TheKerry/RV_main_pcb_ESP32/Software/0x036 CAN CONF.png

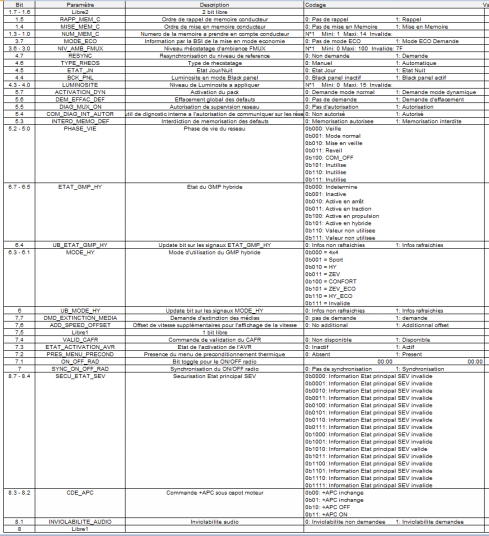
Software/0x036 CAN CONF.png
