TheKerry/RV_main_pcb_ESP32/Software/V1/readme.txt

CAN frames von Arduino auslesen und einzelne bits in Variablen speichern.
ESP fragt einfach nach 8 bits und bekommt diese zurück
