TheKerry/RV_main_pcb_ESP32/Software/0x1A CAN LS CAR.png

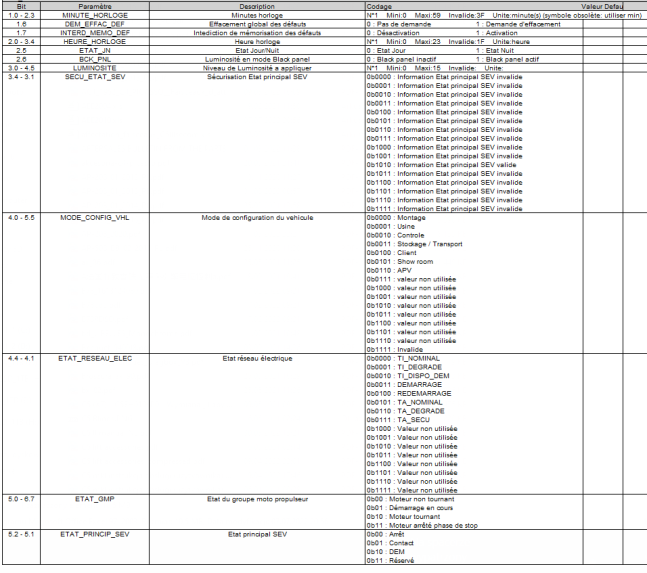
Software/0x1A CAN LS CAR.png
