TheKerry/RV_main_pcb_ESP32/RV_main_pcb_ESP32/RV_main_pcb_ESP32.kicad_pcb

## KiCad design RV_main_pcb_ESP32/RV_main_pcb_ESP32.kicad_pcb (2022-05-26)

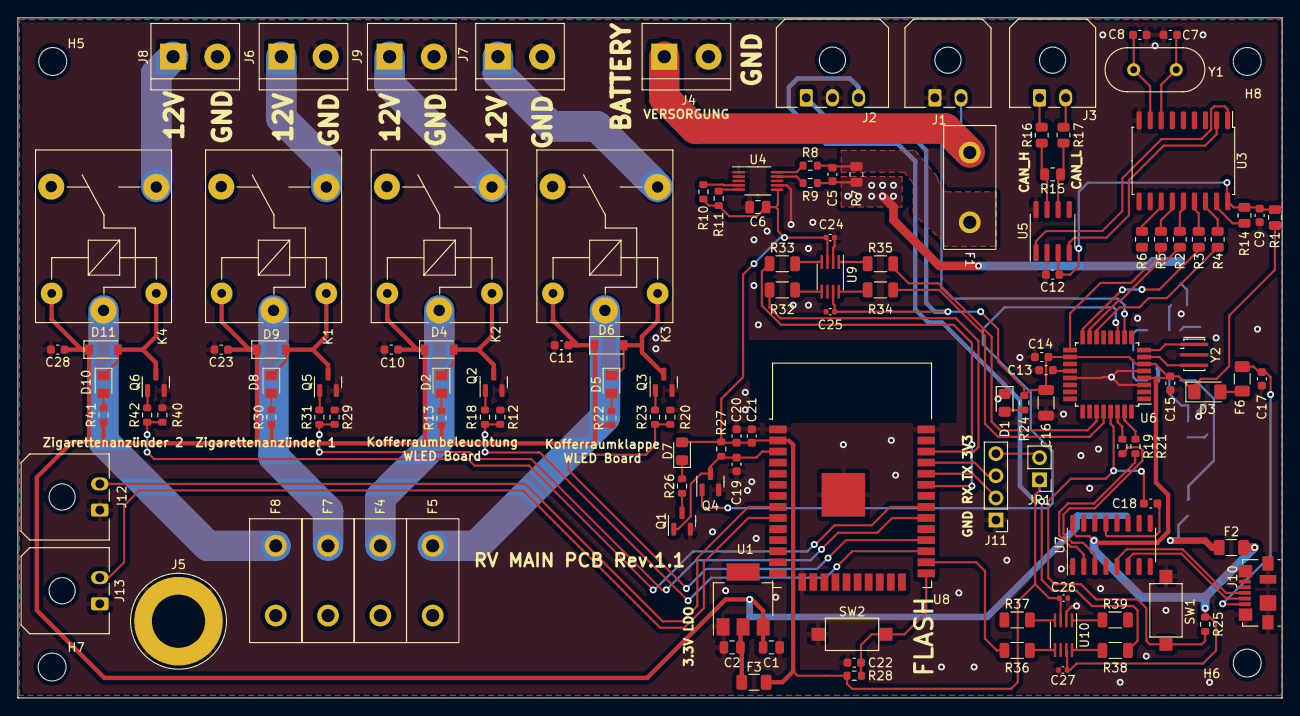
[picture p17: board RV_main_pcb_ESP32.kicad_pcb from above]

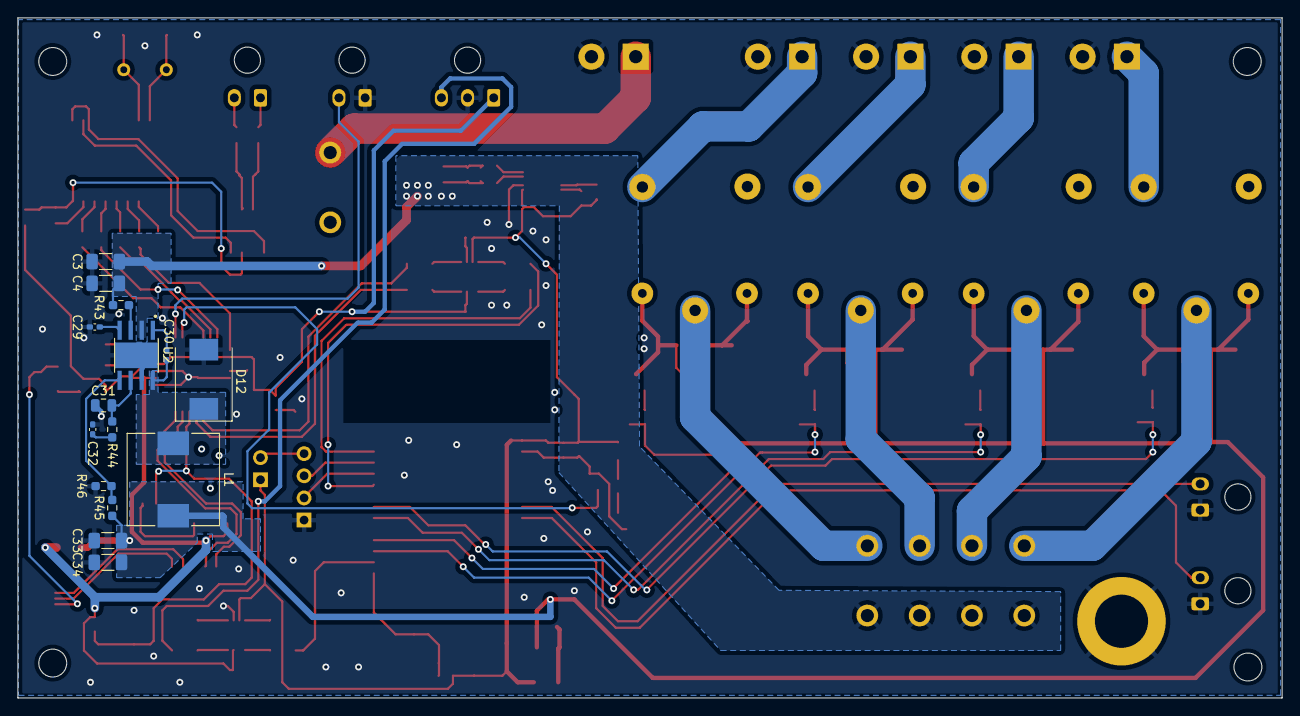
[picture p18: board RV_main_pcb_ESP32.kicad_pcb from below]

Board: 2 copper layers, 145.0 x 78.0 mm, 143 parts (15 on the bottom side), 101 nets.

Parts:
C1, C2, C6: 0.1uF; C_0805_2012Metric
C3, C4: 10uF; C_1206_3216Metric_Pad1.33x1.80mm_HandSolder
C5, C19, C22: 0.1uF; C_0603_1608Metric
C7, C8, C9, C12: C; C_0603_1608Metric
C10, C11, C23, C28: 10uF; C_0603_1608Metric
C13, C14, C15, C17, C18, C20: 100nF; C_0603_1608Metric
C16: 4,7uF 16V; C_1206_3216Metric
C21: 22uF; C_0603_1608Metric
C24, C25, C26, C27: 100nF; C_0402_1005Metric
C29: 22uF; C_0402_1005Metric_Pad0.74x0.62mm_HandSolder
C30, C32: 100nF; C_0402_1005Metric_Pad0.74x0.62mm_HandSolder
C31: 10pF; C_0805_2012Metric
C33, C34: 47uF; C_1206_3216Metric_Pad1.33x1.80mm_HandSolder
D1, D7: GREEN; LED_0805_2012Metric_Pad1.15x1.40mm_HandSolder
D2, D5, D8, D10: LED; LED_0805_2012Metric_Pad1.15x1.40mm_HandSolder
D3: D_Filled; D_1206_3216Metric_Pad1.42x1.75mm_HandSolder
D4, D6, D9, D11: 1N4148W; D_SOD-123
D12: B340; D_SMC
F1, F4, F5, F7, F8: 10A; Flachsicherung
F2, F6: 0.5A; Fuse_1206_3216Metric
F3: 1A; Fuse_1206_3216Metric
H5, H6, H7, H8: MountingHole; MountingHole_3.2mm_M3
J1, J3, J12, J13: Conn_01x02_Male; Molex_Micro-Fit_3.0_43650-0200_1x02_P3.00mm_Horizontal
J2: Molex Micro-fit 3x1; Molex_Micro-Fit_3.0_43650-0300_1x03_P3.00mm_Horizontal
J4, J6, J7, J8, J9: Conn_01x02_Male; TerminalBlock_bornier-2_P5.08mm
J5: Conn_01x01_Female; Banana_Jack_1Pin
J10: USB_B_Micro; USB_Micro-B_Molex_47346-0001
J11: Conn_01x04_Male; PinHeader_1x04_P2.54mm_Vertical
JP1: Jumper_2_Open; PinHeader_1x02_P2.54mm_Vertical
K1, K2, K3, K4: SANYOU_SRD_Form_C; Relay_SPDT_SANYOU_SRD_Series_Form_C
L1: 6.8uH; L_10.4x10.4_H4.8
Q1, Q2, Q3, Q4, Q5, Q6: AO3400A; SOT-23
R1, R2, R3, R4, R5, R6, R16, R17: 0; R_0805_2012Metric
R7: 0.01; R_0805_2012Metric
R8, R9: 10; R_0603_1608Metric
R10, R11: 4,7k; R_0603_1608Metric
R12, R20, R25, R27, R28, R29, R40: 10k; R_0603_1608Metric
R13, R22, R30, R41: R; R_0603_1608Metric
R14: 10k; R_0805_2012Metric
R15: 120; R_0805_2012Metric
R18, R23, R31, R42: 100; R_0603_1608Metric
R19, R21: 1k; R_0603_1608Metric
R24: 250; R_0603_1608Metric
R26: 125; R_0603_1608Metric
R32, R33, R34, R35, R36, R37, R38, R39: 0; R_1206_3216Metric
R43: 0; R_0603_1608Metric_Pad0.98x0.95mm_HandSolder
R44: 61.9k; R_0603_1608Metric_Pad0.98x0.95mm_HandSolder
R45: 10.2k; R_0603_1608Metric_Pad0.98x0.95mm_HandSolder
R46: 1.96k; R_0603_1608Metric_Pad0.98x0.95mm_HandSolder
SW1, SW2: SW_Push; SW_SPST_CK_RS282G05A3
U1: LM1117-5; SOT-223
U2: TPS54331DDAR; CONV_TPS54331DDAR
U3: MCP2515-xSO; SOIC-18W_7.5x11.6mm_P1.27mm
U4: INA226; VSSOP-10_3x3mm_P0.5mm
U5: TJA1051T; SOIC-8_3.9x4.9mm_P1.27mm
U6: ATmega328P-A; TQFP-32_7x7mm_P0.8mm
U7: CH340C; SOIC-16_3.9x9.9mm_P1.27mm
U8: ESP32-WROOM-32
U9, U10: TXS0102DCT; SSOP-8_2.95x2.8mm_P0.65mm
Y1: Crystal; Crystal_HC49-4H_Vertical
Y2: Crystal_GND2; Resonator_SMD_Murata_CSTxExxV-3Pin_3.0x1.1mm_HandSoldering

Connections:
+5V: C1.1, C10.1, C11.1, C23.1, C28.1, C33.1, C34.1, D4.1 (K), D6.1 (K), D9.1 (K), D11.1 (K), F2.1, K1.5, K2.5, K3.5, K4.5, L1.2, R13.1, R22.1, R30.1, R41.1, R45.2, U1.3 (VI)
+12V: C3.1, C4.1, C5.1, F4.2, F5.2, F7.2, F8.2, R7.1, R9.2, R43.1, U2.2 (VIN)
/5V 3A Buck/TPS_PH: C30.2, D12.1 (K), L1.1, U2.8 (PH)
/CAN Interface/CAN_H: J3.1, R16.2
/CAN Interface/CAN_L: J3.2, R17.2
/CAN Interface/VCC: C9.1, C12.1, R1.2, R14.2, U3.18 (VDD), U5.3 (VCC)
/ESP32/ESP_RX: J11.2, U8.34 (RXD0/IO3)
/ESP32/ESP_TX: J11.3, U8.35 (TXD0/IO1)
/LM1117 fixed voltage1/VOUT: C2.2, F3.1, U1.2 (VO)
/Relay 10A1/NO: J7.1, K3.3
/Relay 10A2/NO: J6.1, K1.3
/Relay 10A3/NO: J8.1, K4.3
/Relay 10A/NO: J9.1, K2.3
BATTERY: C5.2, F1.2, R7.2, R8.1
CAN_CS: R4.1, U6.14 (PB2)
CAN_MISO: R3.1, U6.16 (PB4)
CAN_MOSI: R2.1, U6.15 (PB3)
CAN_RX: U3.2 (RXCAN), U5.4 (RXD)
CAN_SCK: R5.1, U6.17 (PB5)
CAN_TX: U3.1 (TXCAN), U5.1 (TXD)
ESP32_EN_INT: C19.1, Q1.1 (G), Q4.3 (D), R27.1, U8.3 (EN)
ESP32_RELAY_1: R12.1, R18.1, U8.27 (IO16)
ESP32_RELAY_2: R20.1, R23.1, U8.28 (IO17)
ESP32_RELAY_3: R29.1, R31.1, U8.30 (IO18)
ESP32_RELAY_4: R40.1, R42.1, U8.31 (IO19)
ESP32_VCC: C6.1, C20.1, C21.1, C24.2, C26.2, D7.2 (A), F3.2, JP1.1 (A), R10.2, R11.1, R27.2, R28.2, U4.6 (VS), U8.2 (VDD), U9.3 (VCCA), U10.3 (VCCA)
ESP32_WS2812B_status_LED_3.3V: R36.1, U8.26 (IO4)
ESP32_WS2812B_status_LED_5V: J2.3, R38.2
ESP-32_SCL_3.3V: R32.1, U8.36 (IO22)
ESP-32_SDA_3.3V: R33.1, U8.33 (IO21)
ESP_SW1: J12.2, U8.8 (IO32)
ESP_SW2: J13.2, U8.9 (IO33)
GND: C1.2, C2.1, C3.2, C4.2, C6.2, C7.1, C8.1, C9.2, C10.2, C11.2, C12.2, C13.1, C14.2, C15.2, C16.2, C17.1, C19.2, C20.2, C21.2, C22.2, C23.2, C24.1, C25.2, C26.1, C27.2, C28.2, C29.1, C31.1, C32.1, C33.2, C34.2, D1.1 (K), D12.2 (A), J1.1, J2.2, J4.2, J5.1, J6.2, J7.2, J8.2, J9.2, J10.5 (GND), J10.6 (Shield), J11.1, J12.1, J13.1, Q1.2 (S), Q2.2 (S), Q3.2 (S), Q4.2 (S), Q5.2 (S), Q6.2 (S), R12.2, R20.2, R29.2, R40.2, R46.1, SW1.1, SW2.1, U1.1 (GND), U2.7 (GND), U2.9 (POWERPAD), U3.9 (VSS), U4.1 (A1), U4.2 (A0), U4.7 (GND), U5.2 (GND), U5.8 (S), U6.3 (GND), U6.5 (GND), U6.21 (GND), U7.1 (GND), U8.1 (GND), U8.15 (GND), U8.38 (GND), U8.39 (GND), U9.2 (GND), U10.2 (GND), Y2.2
NANO_5V: C14.1, C15.1, C16.1, C25.1, C27.1, D3.1 (K), F2.2, J2.1, R1.1, R24.1, R25.2, U6.4 (VCC), U6.6 (VCC), U6.18 (AVCC), U7.16 (VCC), U9.7 (VCCB), U10.7 (VCCB)
NANO_D6: J1.2, U6.10 (PD6)
NANO_D7: Q4.1 (G), U6.11 (PD7)
NANO_RESET: C18.2, R25.1, SW1.2, U6.29 (~RESET/PC6)
NANO_RX: R19.2, U7.3 (RXD)
NANO_SCL_5V: R34.2, U6.28 (PC5)
NANO_SDA_5V: R35.2, U6.27 (PC4)
NANO_TX: R21.2, U7.2 (TXD)
unnamed: C7.2, U3.7 (OSC2), Y1.2
unnamed: C8.2, U3.8 (OSC1), Y1.1
unnamed: C13.2, U6.20 (AREF)
unnamed: C17.2, F6.1, J10.1 (VBUS)
unnamed: C18.1, U7.13 (~DTR)
unnamed: C22.1, R28.1, SW2.2, U8.25 (IO0)
unnamed: C29.2, U2.4 (SS)
unnamed: C30.1, U2.1 (BOOT)
unnamed: C31.2, R44.1, U2.6 (COMP)
unnamed: C32.2, R44.2
unnamed: D1.2 (A), R24.2
unnamed: D2.1 (K), D4.2 (A), K2.2, Q2.3 (D)
unnamed: D2.2 (A), R13.2
unnamed: D3.2 (A), F6.2
unnamed: D5.1 (K), D6.2 (A), K3.2, Q3.3 (D)
unnamed: D5.2 (A), R22.2
unnamed: D7.1 (K), R26.2
unnamed: D8.1 (K), D9.2 (A), K1.2, Q5.3 (D)
unnamed: D8.2 (A), R30.2
unnamed: D10.1 (K), D11.2 (A), K4.2, Q6.3 (D)
unnamed: D10.2 (A), R41.2
unnamed: F1.1, J4.1
unnamed: F4.1, K2.1
unnamed: F5.1, K3.1
unnamed: F7.1, K1.1
unnamed: F8.1, K4.1
unnamed: J10.2 (D-), U7.6 (UD-)
unnamed: J10.3 (D+), U7.5 (UD+)
unnamed: J11.4, JP1.2 (B)
unnamed: Q1.3 (D), R26.1
unnamed: Q2.1 (G), R18.2
unnamed: Q3.1 (G), R23.2
unnamed: Q5.1 (G), R31.2
unnamed: Q6.1 (G), R42.2
unnamed: R2.2, U3.14 (SI)
unnamed: R3.2, U3.15 (SO)
unnamed: R4.2, U3.16 (~CS)
unnamed: R5.2, U3.13 (SCK)
unnamed: R6.1, U3.12 (~INT)
unnamed: R8.2, U4.10 (Vin+)
unnamed: R9.1, U4.9 (Vin-)
unnamed: R14.1, U3.17 (~RESET)
unnamed: R15.1, R17.1, U5.6 (CANL)
unnamed: R15.2, R16.1, U5.7 (CANH)
unnamed: R19.1, U6.30 (PD0)
unnamed: R21.1, U6.31 (PD1)
unnamed: R32.2, U9.5 (A1)
unnamed: R33.2, U9.4 (A2)
unnamed: R34.1, U9.8 (B1)
unnamed: R35.1, U9.1 (B2)
unnamed: R36.2, U10.5 (A1)
unnamed: R37.2, U10.4 (A2)
unnamed: R38.1, U10.8 (B1)
unnamed: R39.1, U10.1 (B2)
unnamed: R43.2, U2.3 (EN)
unnamed: U6.7 (XTAL1/PB6), Y2.3
unnamed: U6.8 (XTAL2/PB7), Y2.1
SCK: R11.2, U4.5 (SCL)
SD: R10.1, U4.4 (SDA)
TPS_VSENSE: R45.1, R46.2, U2.5 (VSENSE)
