TheKerry/RV_main_pcb_ESP32/(commit log)

2022-02-02 Version 1 verworfen
    [RV_main_pcb_ESP32.kicad_pcb, RV_main_pcb_ESP32.kicad_sch]
2022-02-08 drawio inserted
2022-05-21 assembly V1
    [5V_buck.kicad_sch, CAN_Interface.kicad_sch, LM1117_fixed.kicad_sch, NANO.kicad_sch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]
2022-05-26 Software initial upload
    [ESP32.kicad_sch, RV_main_pcb_ESP32.kicad_sch, Relay_10A.kicad_sch, changelog.kicad_sch, configuration.h]
2022-07-19 update CAN Frames
    [RV_main_pcb_ESP32.kicad_pcb]
2022-07-29 updated V2 Software excluded CAN
    [configuration.h]
2022-07-31 updated V2 Software
    [configuration.h]
